alanmitchell/diff-temp-controller/(commit log)

2015-11-07 Add Board Diagram.
2015-11-07 Added the Arduino Sketch.
2015-11-07 Updated description and board diagram.
2015-11-07 Added schematic diagram.
2015-11-07 Reference to schematic.
